ercknz/BME383-EMGcar/Images/IMG3.jpeg

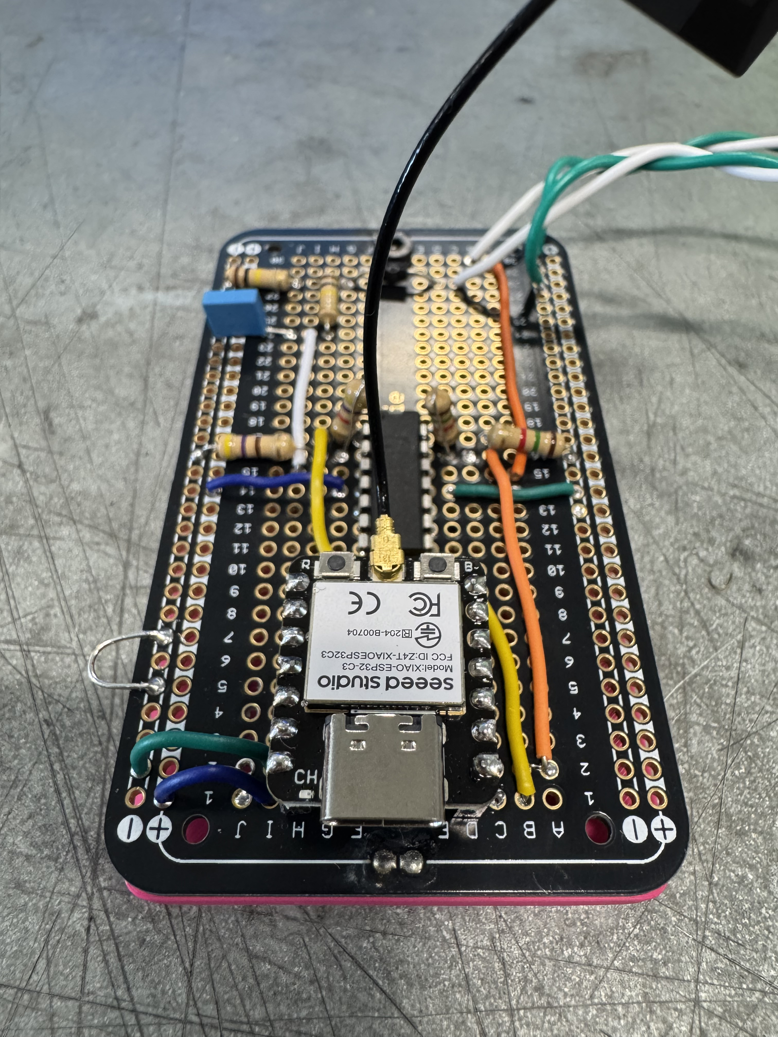
Images/IMG3.jpeg
