ercknz/BME383-EMGcar/Images/IMG4.jpeg

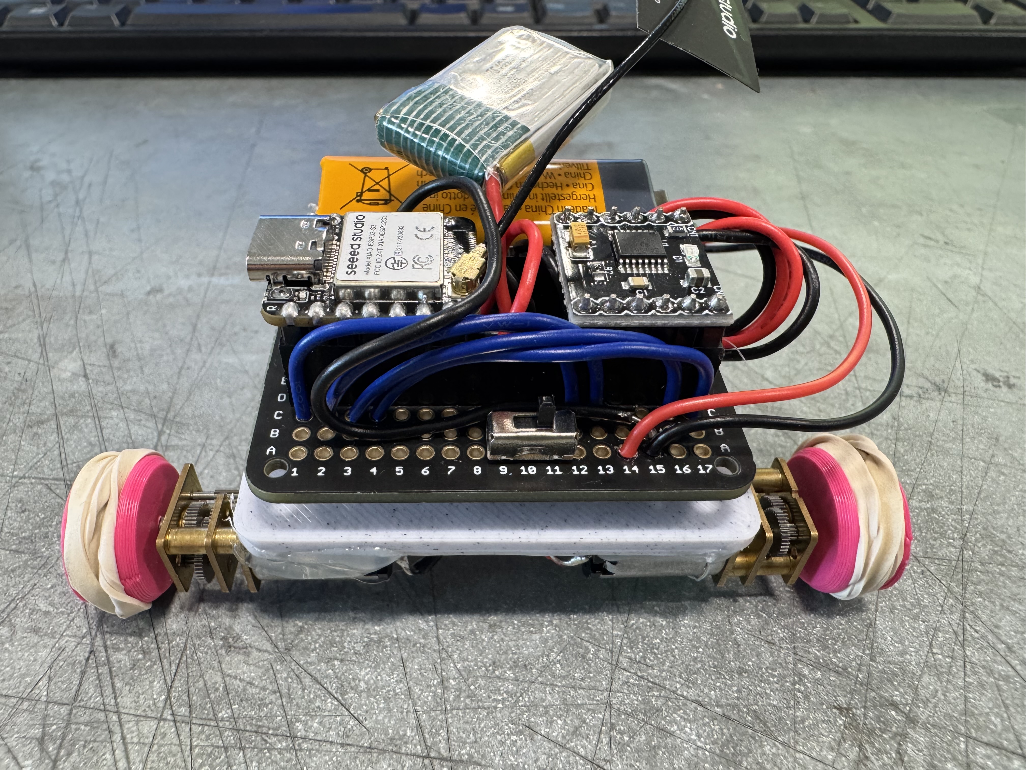
Images/IMG4.jpeg
