ercknz/BME383-EMGcar/Images/IMG0.jpeg

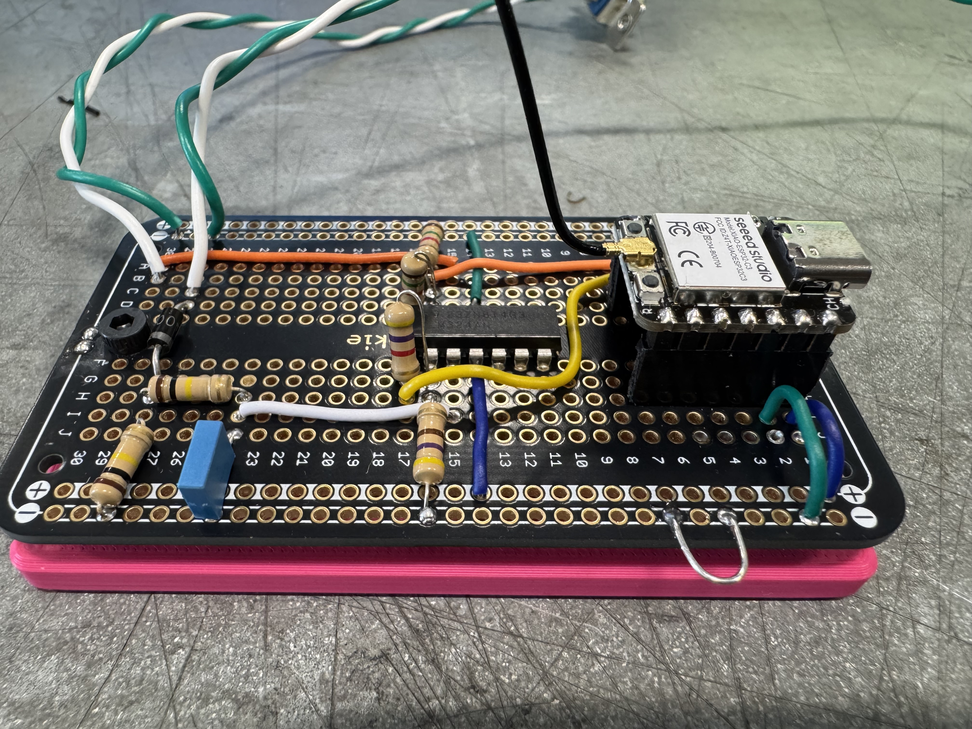
Images/IMG0.jpeg
