ercknz/BME383-EMGcar/Images/IMG6.jpeg

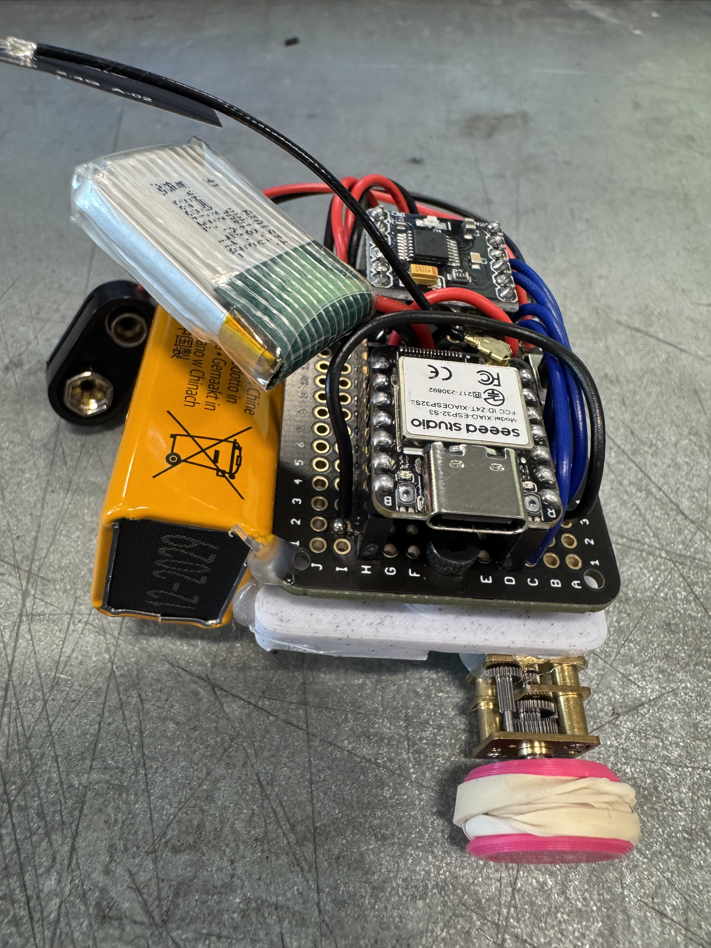
Images/IMG6.jpeg
