ercknz/BME383-EMGcar/STLfiles/gate.STL

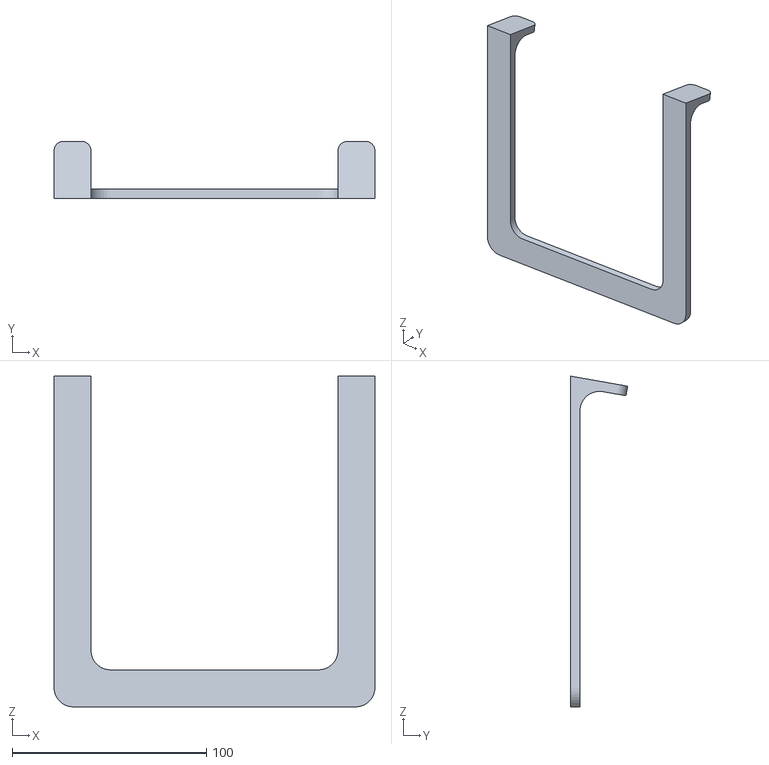
[picture p16: CAD file, 2026-11-06]
STLfiles/gate.STL
165.1 x 29.5 x 170.2
