ercknz/BME383-EMGcar/STLfiles/carBase.STL

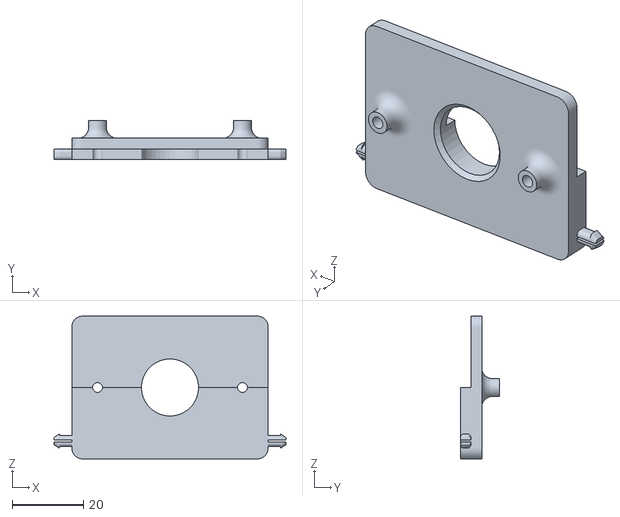
[picture p17: CAD file, 2026-11-06]
STLfiles/carBase.STL
65.0 x 11.0 x 40.0
