ercknz/BME383-EMGcar/STLfiles/transmitterBase.STL

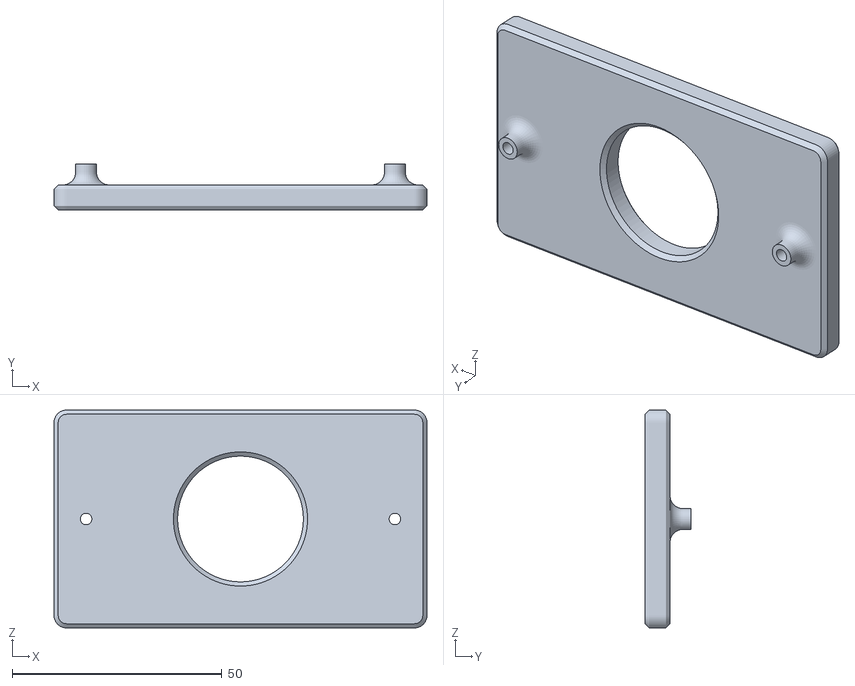
[picture p18: CAD file, 2026-11-06]
STLfiles/transmitterBase.STL
89.0 x 11.0 x 52.0
