ercknz/BME383-EMGcar/STLfiles/tackHolder.STL

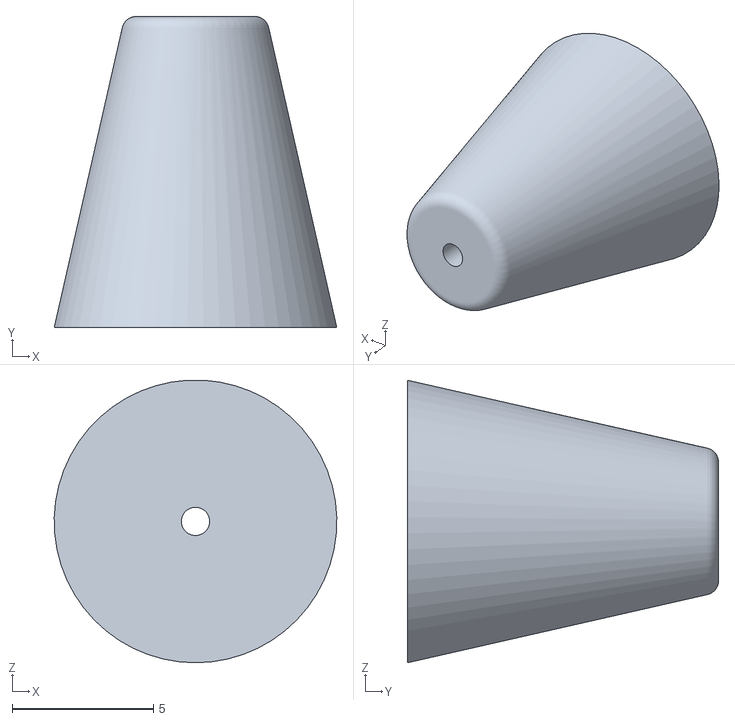
[picture p19: CAD file, 2026-11-06]
STLfiles/tackHolder.STL
10.00 x 11.0 x 9.99
