ercknz/BME383-EMGcar/STLfiles/wheel.STL

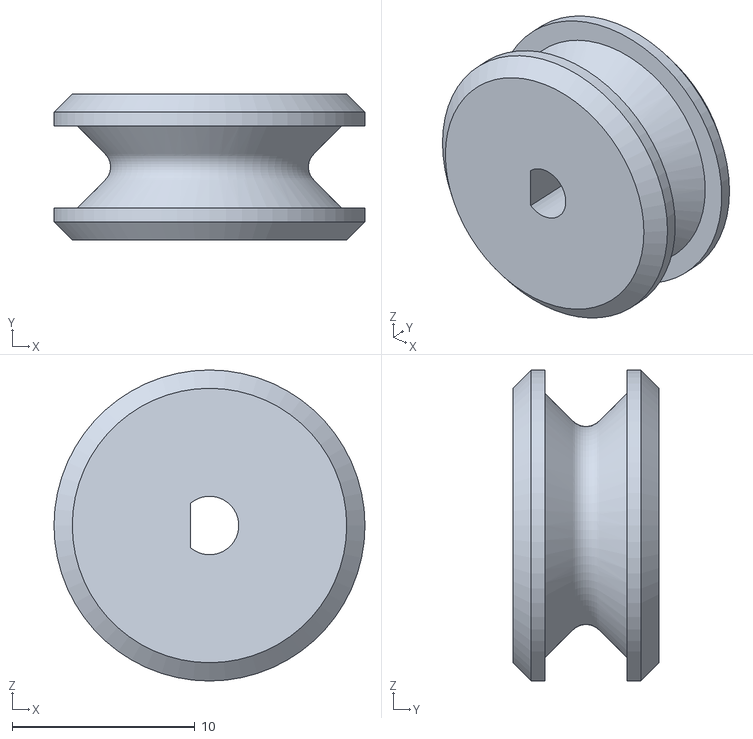
[picture p20: CAD file, 2026-11-06]
STLfiles/wheel.STL
17.0 x 8.00 x 17.0
